vuquangtrong/ethernet_rfid_reader/doc/hw_front_v1.png

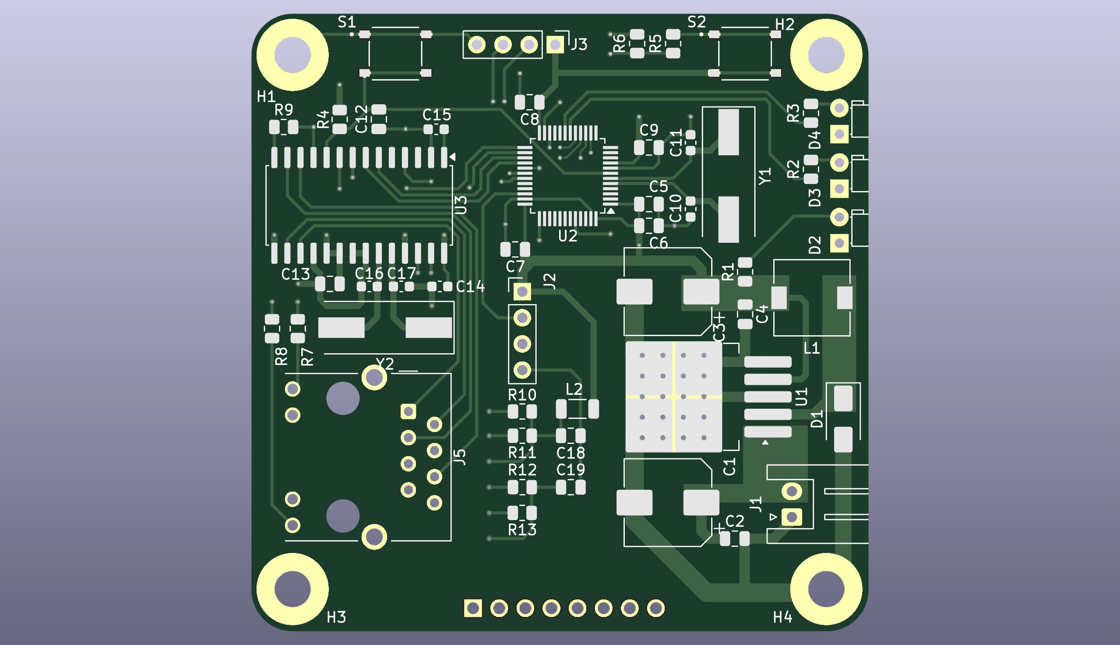
doc/hw_front_v1.png
