vuquangtrong/ethernet_rfid_reader/doc/hw_back_v1.png

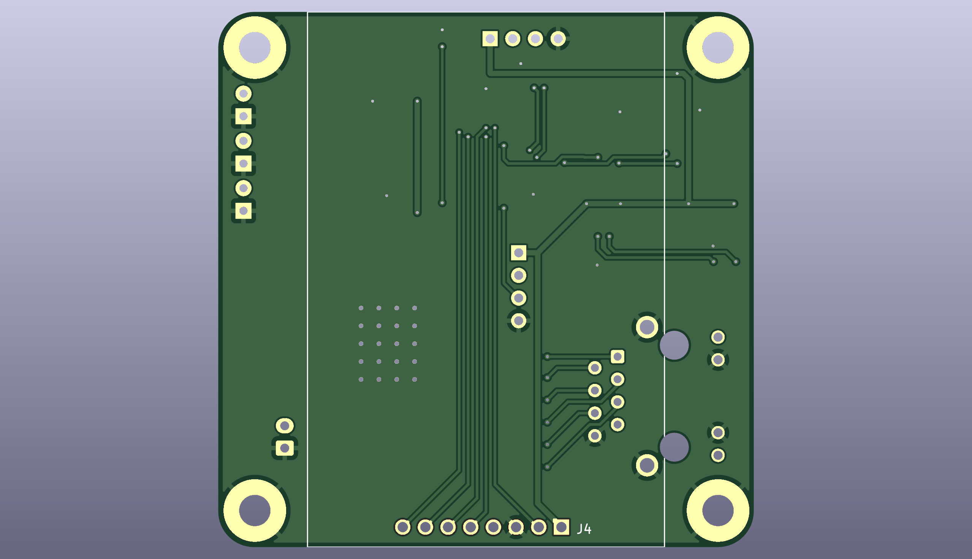
doc/hw_back_v1.png
