vuquangtrong/ethernet_rfid_reader/doc/hw_3d_v1.1.png

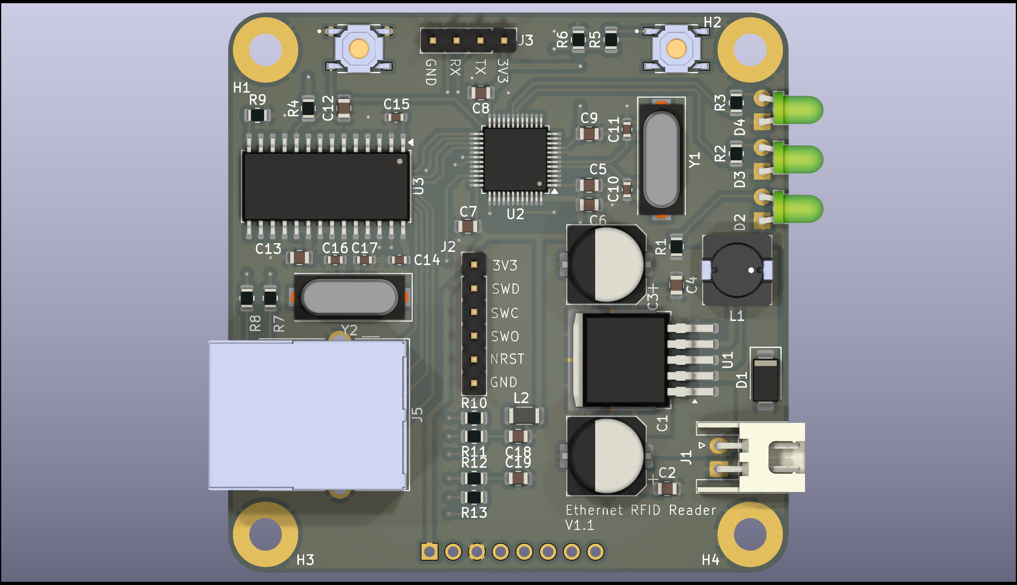
doc/hw_3d_v1.1.png
