vuquangtrong/ethernet_rfid_reader/hardware/ethernet_rfid_reader.kicad_pcb

## KiCad design hardware/ethernet_rfid_reader.kicad_pcb (2024-12-01)

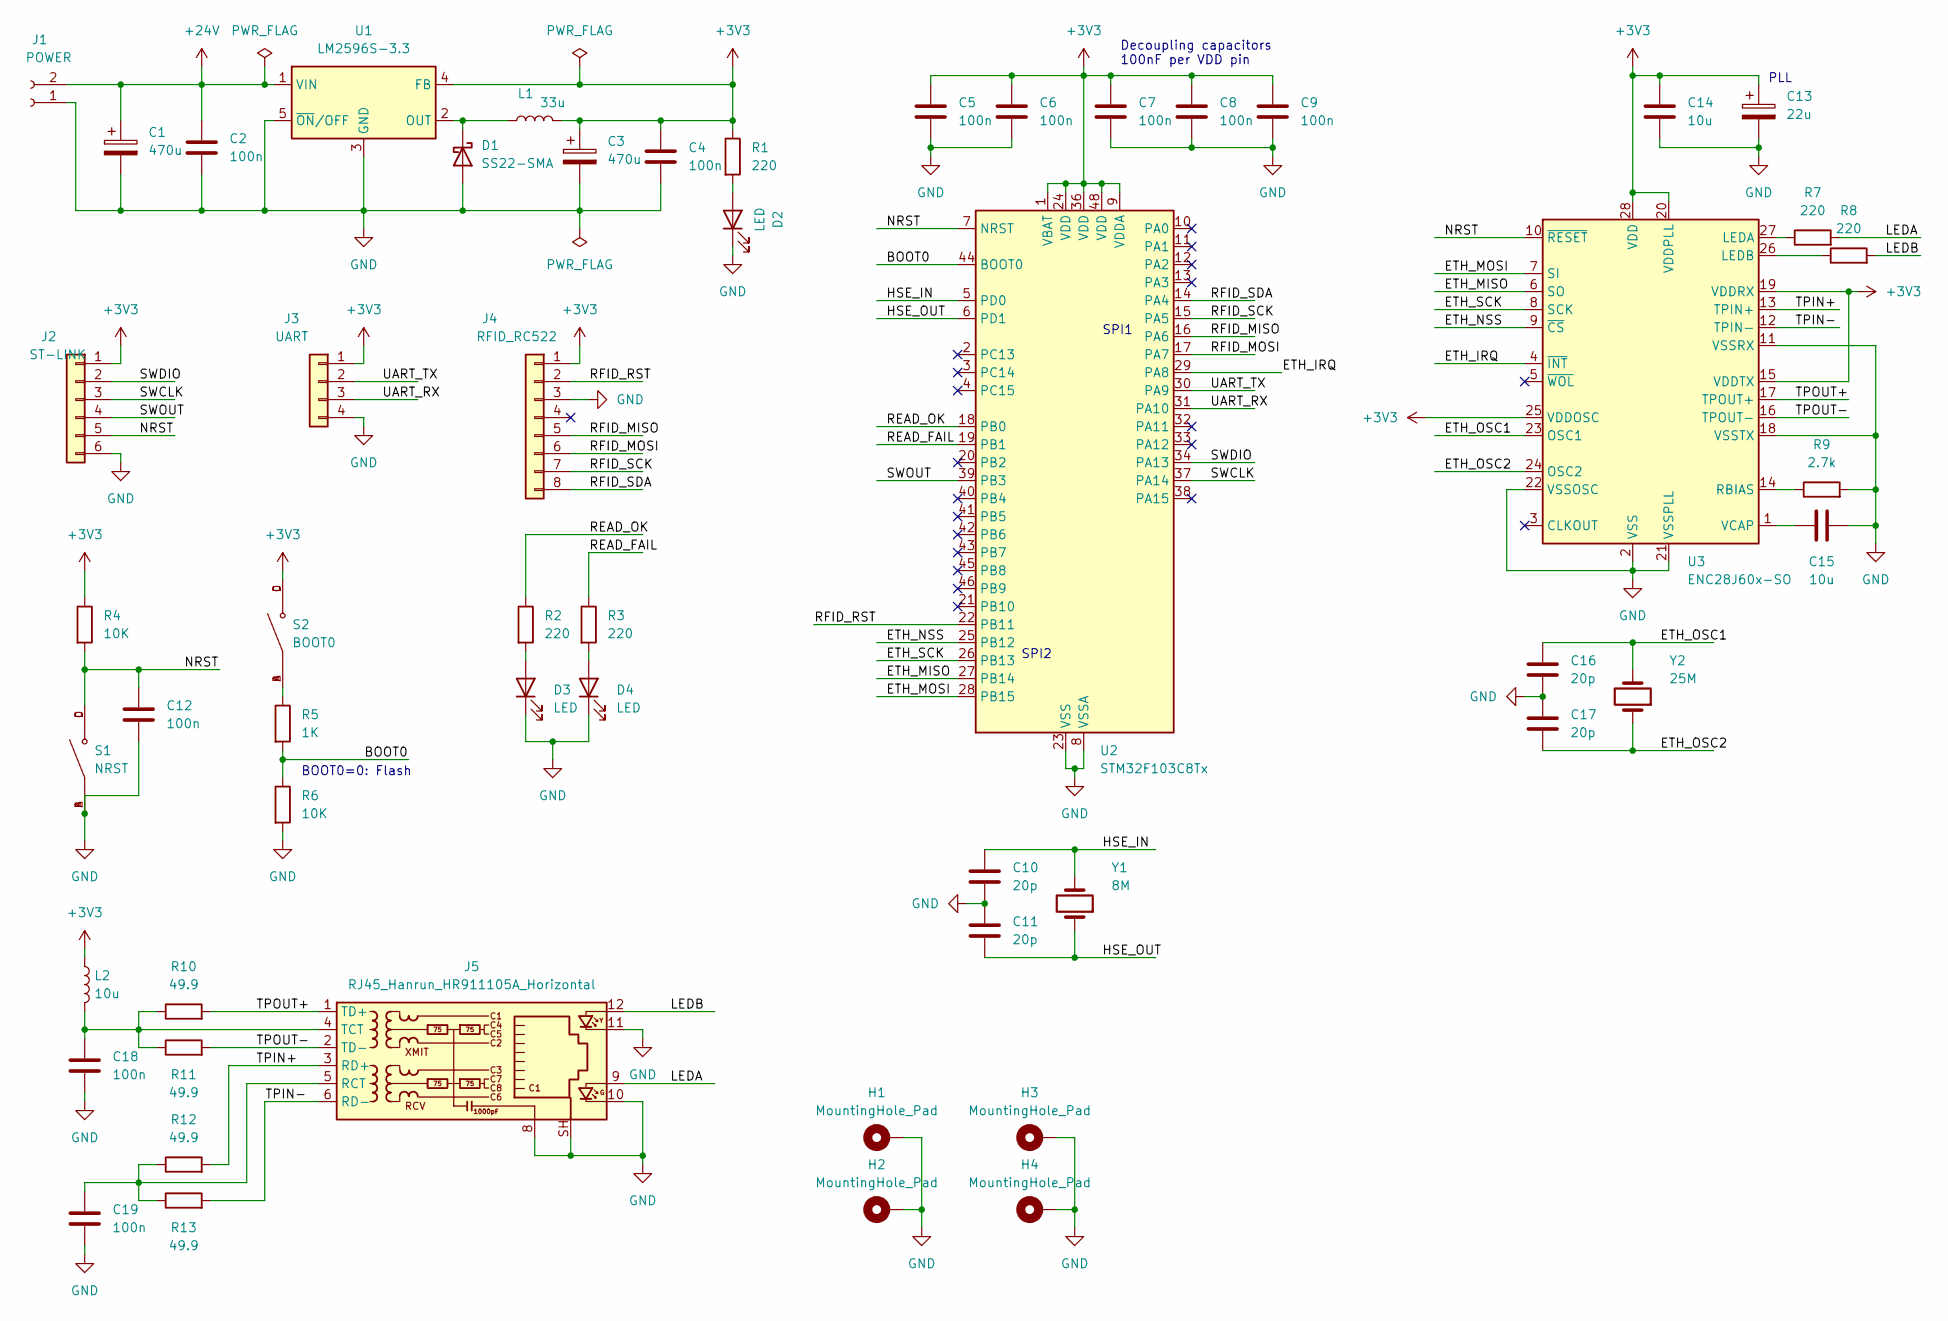
[picture p5: schematic ethernet_rfid_reader.kicad_sch, Ethernet RFID Reader]

Parts:
C1, C3: 470u; CP_Elec_8x10
C2, C4, C5, C6, C7, C8, C9, C12, C18, C19: 100n; C_0805_2012Metric
C10, C11, C16, C17: 20p; C_0603_1608Metric
C13: 22u; C_0805_2012Metric
C14, C15: 10u; C_0603_1608Metric
D1: SS22-SMA; D_SMA
D2, D3, D4: LED; LED_D3.0mm_Horizontal_O1.27mm_Z2.0mm
H1, H2, H3, H4: MountingHole_Pad; MountingHole_3.5mm_Pad
J1: POWER; JST_XH_S2B-XH-A_1x02_P2.50mm_Horizontal
J2: ST-LINK; PinHeader_1x06_P2.54mm_Vertical
J3: UART; PinHeader_1x04_P2.54mm_Vertical
J4: RFID_RC522; MODULE_CEG006900_1
J5: RJ45_Hanrun_HR911105A_Horizontal
L1: 33u; L_7.3x7.3_H4.5
L2: 10u; L_1206_3216Metric
R1, R2, R3, R7, R8: 220; R_0805_2012Metric
R4, R6: 10K; R_0805_2012Metric
R5: 1K; R_0805_2012Metric
R9: 2.7k; R_0805_2012Metric
R10, R11, R12, R13: 49.9; R_0805_2012Metric
S1: NRST; SW_TS-1187A-B-A-B
S2: BOOT0; SW_TS-1187A-B-A-B
U1: LM2596S-3.3; TO-263-5_TabPin3
U2: STM32F103C8Tx; LQFP-48_7x7mm_P0.5mm
U3: ENC28J60x-SO; SOIC-28W_7.5x17.9mm_P1.27mm
Y1: 8M; Crystal_SMD_HC49-SD
Y2: 25M; Crystal_SMD_HC49-SD

Connections:
+3V3: C3.1, C4.1, C5.1, C6.1, C7.1, C8.1, C9.1, C13.1, C14.1, J2.1, J3.1, J4.1, L1.2, L2.1, R1.1, R4.1, S2.C, S2.D, U1.4 (FB), U2.1 (VBAT), U2.9 (VDDA), U2.24 (VDD), U2.36 (VDD), U2.48 (VDD), U3.15 (VDDTX), U3.19 (VDDRX), U3.20 (VDDPLL), U3.25 (VDDOSC), U3.28 (VDD)
+24V: C1.1, C2.1, J1.2, U1.1 (VIN)
/BOOT0: R5.2, R6.1, U2.44 (BOOT0)
/ETH_IRQ: U2.29 (PA8), U3.4 (~INT)
/ETH_MISO: U2.27 (PB14), U3.6 (SO)
/ETH_MOSI: U2.28 (PB15), U3.7 (SI)
/ETH_NSS: U2.25 (PB12), U3.9 (~CS)
/ETH_OSC1: C16.1, U3.23 (OSC1), Y2.2
/ETH_OSC2: C17.2, U3.24 (OSC2), Y2.1
/ETH_SCK: U2.26 (PB13), U3.8 (SCK)
/HSE_IN: C10.1, U2.5 (PD0), Y1.2
/HSE_OUT: C11.2, U2.6 (PD1), Y1.1
/LEDA: J5.9, R7.2
/LEDB: J5.12, R8.2
/NRST: C12.2, J2.5, R4.2, S1.C, S1.D, U2.7 (NRST), U3.10 (~RESET)
/READ_FAIL: R3.1, U2.19 (PB1)
/READ_OK: R2.1, U2.18 (PB0)
/RFID_MISO: J4.5, U2.16 (PA6)
/RFID_MOSI: J4.6, U2.17 (PA7)
/RFID_RST: J4.2, U2.22 (PB11)
/RFID_SCK: J4.7, U2.15 (PA5)
/RFID_SDA: J4.8, U2.14 (PA4)
/SWCLK: J2.3, U2.37 (PA14)
/SWDIO: J2.2, U2.34 (PA13)
/SWOUT: J2.4, U2.39 (PB3)
/TPIN+: J5.3 (RD+), R12.2, U3.13 (TPIN+)
/TPIN-: J5.6 (RD-), R13.2, U3.12 (TPIN-)
/TPOUT+: J5.1 (TD+), R10.2, U3.17 (TPOUT+)
/TPOUT-: J5.2 (TD-), R11.2, U3.16 (TPOUT-)
/UART_RX: J3.3, U2.31 (PA10)
/UART_TX: J3.2, U2.30 (PA9)
GND: C1.2, C2.2, C3.2, C4.2, C5.2, C6.2, C7.2, C8.2, C9.2, C10.2, C11.1, C12.1, C13.2, C14.2, C15.2, C16.2, C17.1, C18.2, C19.2, D1.2 (A), D2.1 (K), D3.1 (K), D4.1 (K), H1.1, H2.1, H3.1, H4.1, J1.1, J2.6, J3.4, J4.3, J5.8, J5.10, J5.11, J5.SH, R6.2, R9.2, S1.A, S1.B, U1.3 (GND), U1.5 (~ON/OFF), U2.8 (VSSA), U2.23 (VSS), U2.35 (VSS), U2.47 (VSS), U3.2 (VSS), U3.11 (VSSRX), U3.18 (VSSTX), U3.21 (VSSPLL), U3.22 (VSSOSC)
unnamed: D1.1 (K), L1.1, U1.2 (OUT)
unnamed: D2.2 (A), R1.2
unnamed: D3.2 (A), R2.2
unnamed: D4.2 (A), R3.2
unnamed: C19.1, J5.5 (RCT), R12.1, R13.1
unnamed: C18.1, J5.4 (TCT), L2.2, R10.1, R11.1
unnamed: R5.1, S2.A, S2.B
unnamed: R7.1, U3.27 (LEDA)
unnamed: R8.1, U3.26 (LEDB)
unnamed: R9.1, U3.14 (RBIAS)
unnamed: C15.1, U3.1 (VCAP)

Notes on the sheet:
PLL
Decoupling capacitors 100nF per VDD pin
SPI2
SPI1
BOOT0=0: Flash

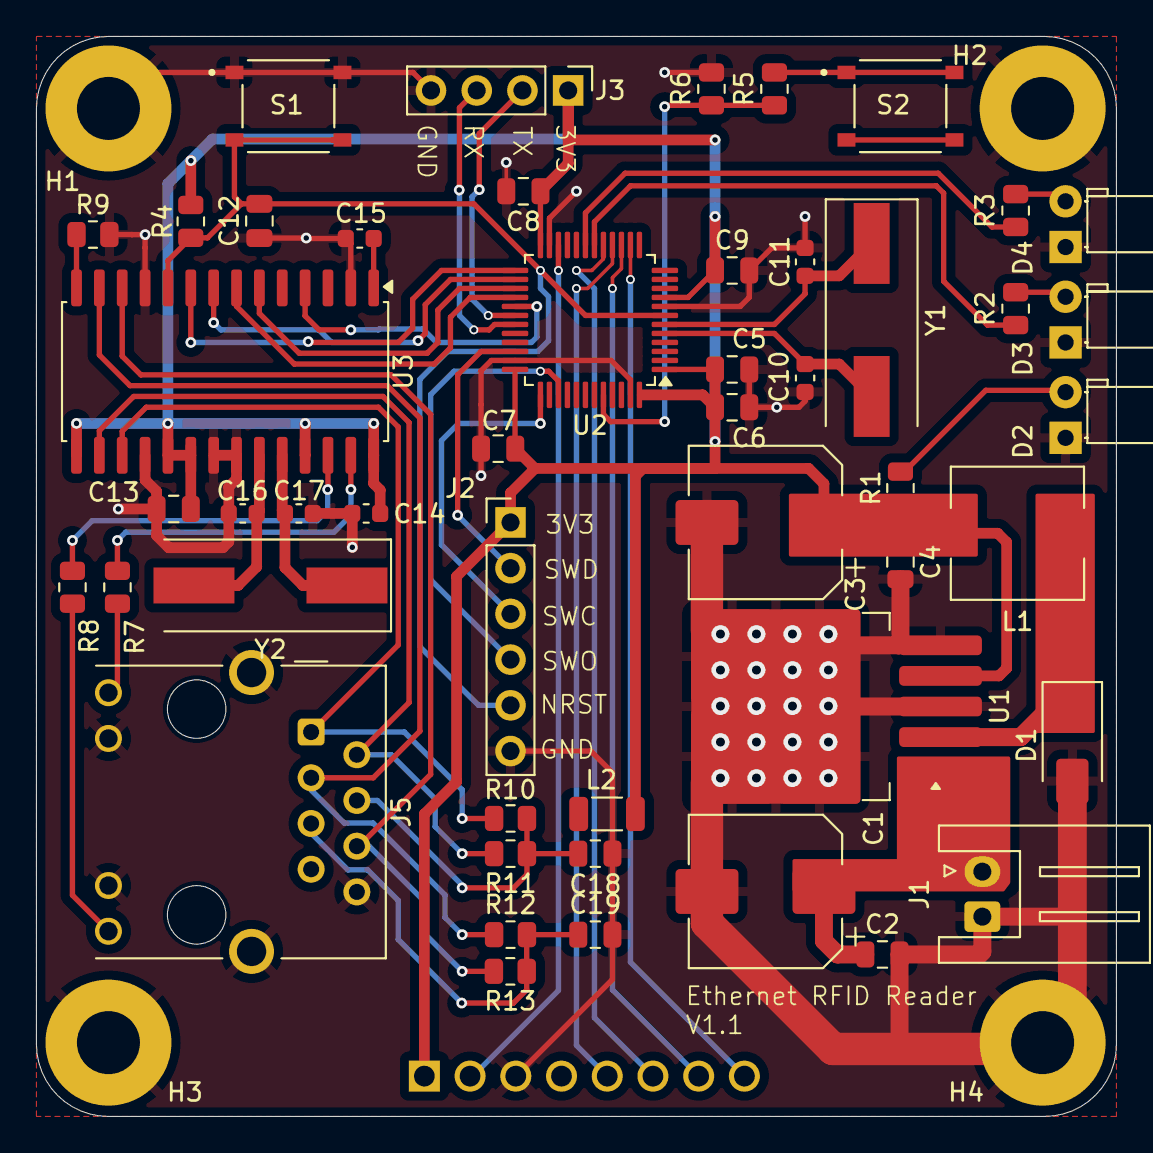
[picture p6: board ethernet_rfid_reader.kicad_pcb from above]

Board: 2 copper layers, 60.0 x 60.0 mm, 54 parts (1 on the bottom side), 43 nets.
