vuquangtrong/ethernet_rfid_reader/firmware/Core/Inc/main.h

#define RFID_SDA_Pin GPIO_PIN_4
#define RFID_SDA_GPIO_Port GPIOA
#define RFID_SCK_Pin GPIO_PIN_5
#define RFID_SCK_GPIO_Port GPIOA
#define RFID_MISO_Pin GPIO_PIN_6
#define RFID_MISO_GPIO_Port GPIOA
#define RFID_MOSI_Pin GPIO_PIN_7
#define RFID_MOSI_GPIO_Port GPIOA
#define READ_OK_Pin GPIO_PIN_0
#define READ_OK_GPIO_Port GPIOB
#define READ_FAIL_Pin GPIO_PIN_1
#define READ_FAIL_GPIO_Port GPIOB
#define RFID_RST_Pin GPIO_PIN_11
#define RFID_RST_GPIO_Port GPIOB
#define ETH_NSS_Pin GPIO_PIN_12
#define ETH_NSS_GPIO_Port GPIOB
#define ETH_SCK_Pin GPIO_PIN_13
#define ETH_SCK_GPIO_Port GPIOB
#define ETH_MISO_Pin GPIO_PIN_14
#define ETH_MISO_GPIO_Port GPIOB
#define ETH_MOSI_Pin GPIO_PIN_15
#define ETH_MOSI_GPIO_Port GPIOB
#define ETH_IRQ_Pin GPIO_PIN_8
#define ETH_IRQ_GPIO_Port GPIOA
