vuquangtrong/ethernet_rfid_reader/(commit log)

2024-11-09 Init project, hardware v1.0
    [BOM-ethernet_rfid_reader.csv, ethernet_rfid_reader.kicad_pcb, ethernet_rfid_reader.kicad_sch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]
2024-12-01 Add ENC28J60 driver
2024-12-01 Update hardware to v1.1
    [ethernet_rfid_reader.kicad_pcb, ethernet_rfid_reader.kicad_sch]
